Snuperim/esp32-c3-robot-arm-workshop/webots/meshes/forearm_frame.stl

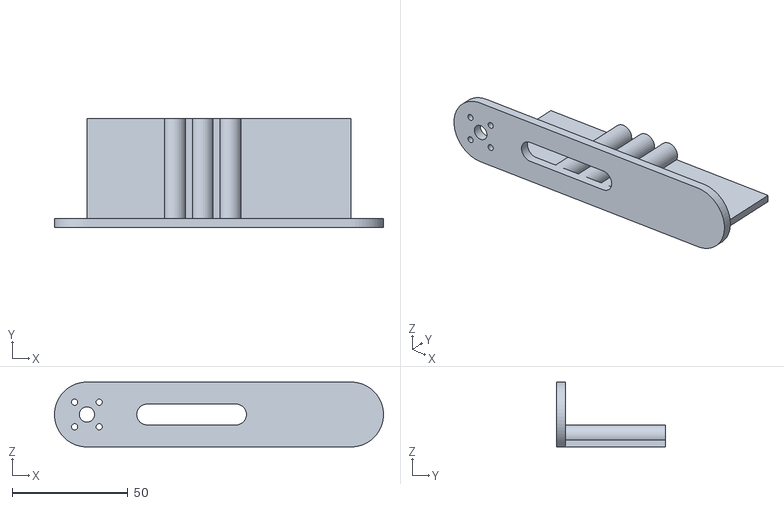
[picture p1: CAD file, 2026-10-28]
webots/meshes/forearm_frame.stl
142.0 x 47.2 x 28.0
