Snuperim/esp32-c3-robot-arm-workshop/webots/meshes/upper_arm_frame.stl

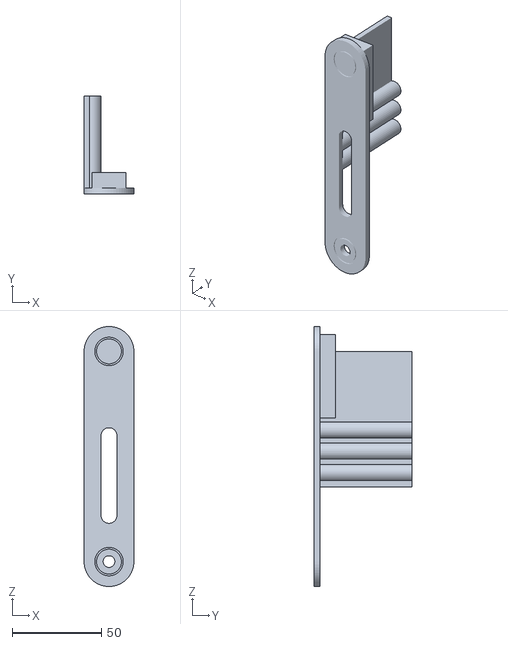
[picture p2: CAD file, 2026-10-28]
webots/meshes/upper_arm_frame.stl
28.0 x 55.2 x 146.0
