Snuperim/esp32-c3-robot-arm-workshop/webots/meshes/finger.stl

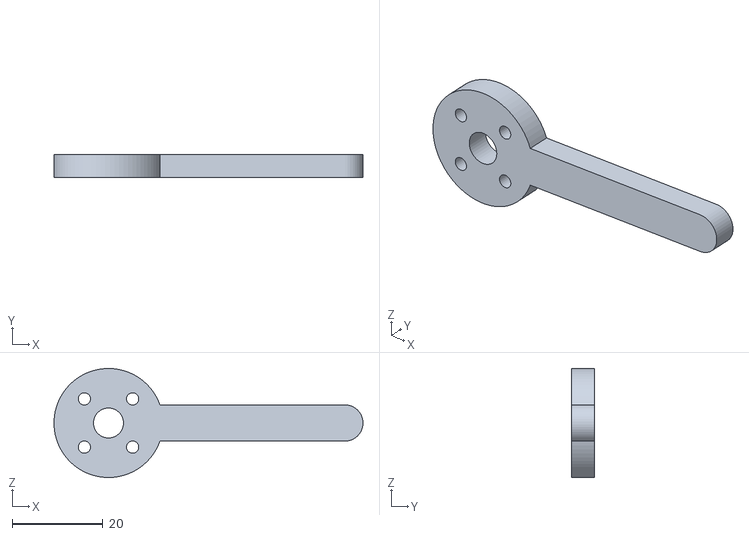
[picture p3: CAD file, 2026-10-28]
webots/meshes/finger.stl
68.0 x 5.00 x 24.0
