Snuperim/esp32-c3-robot-arm-workshop/webots/meshes/upper_arm_plate_a.stl

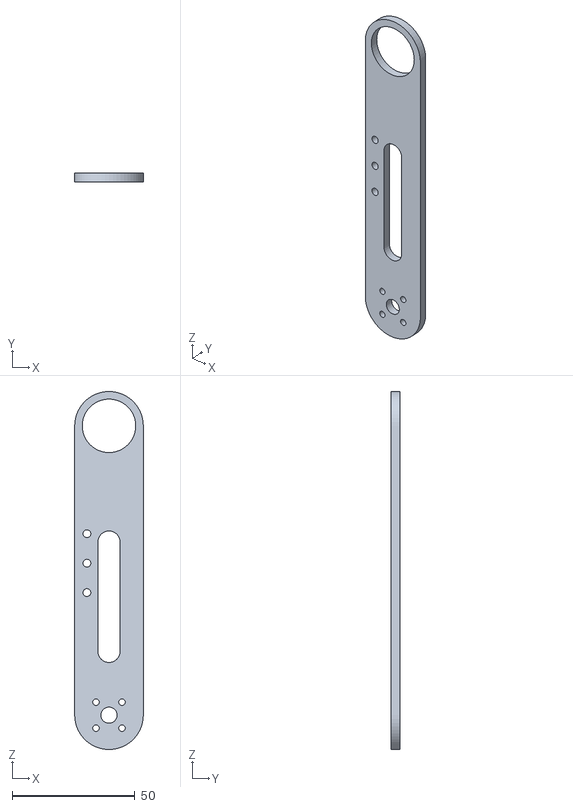
[picture p4: CAD file, 2026-10-28]
webots/meshes/upper_arm_plate_a.stl
28.0 x 3.50 x 146.0
