Snuperim/esp32-c3-robot-arm-workshop/webots/meshes/forearm_outer.stl

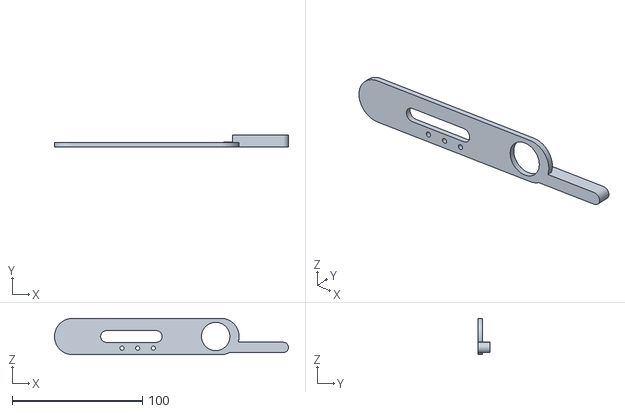
[picture p5: CAD file, 2026-10-28]
webots/meshes/forearm_outer.stl
180.0 x 9.00 x 28.0
