Snuperim/esp32-c3-robot-arm-workshop/webots/meshes/upper_arm.stl

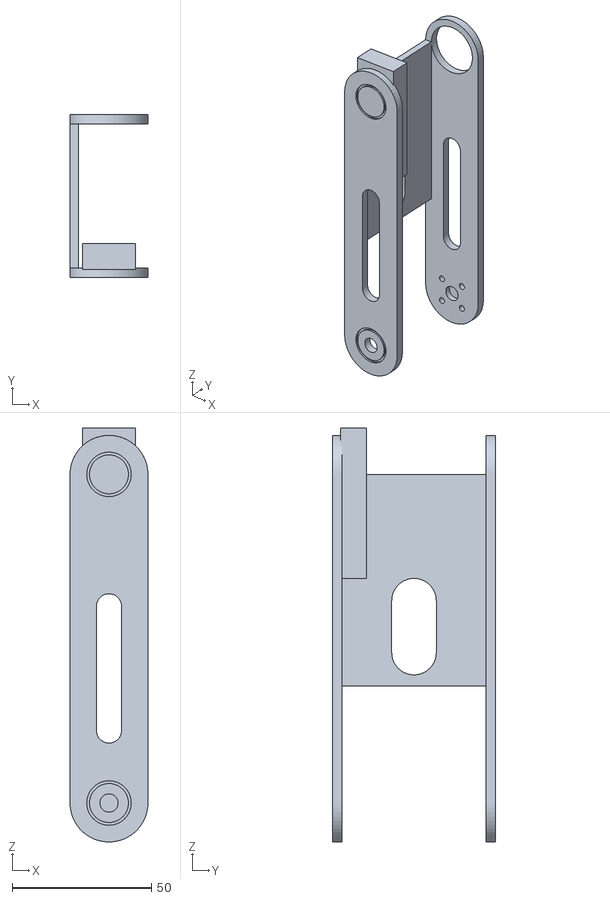
[picture p6: CAD file, 2026-10-27]
webots/meshes/upper_arm.stl
28.0 x 58.7 x 148.6
