Snuperim/esp32-c3-robot-arm-workshop/webots/meshes/forearm.stl

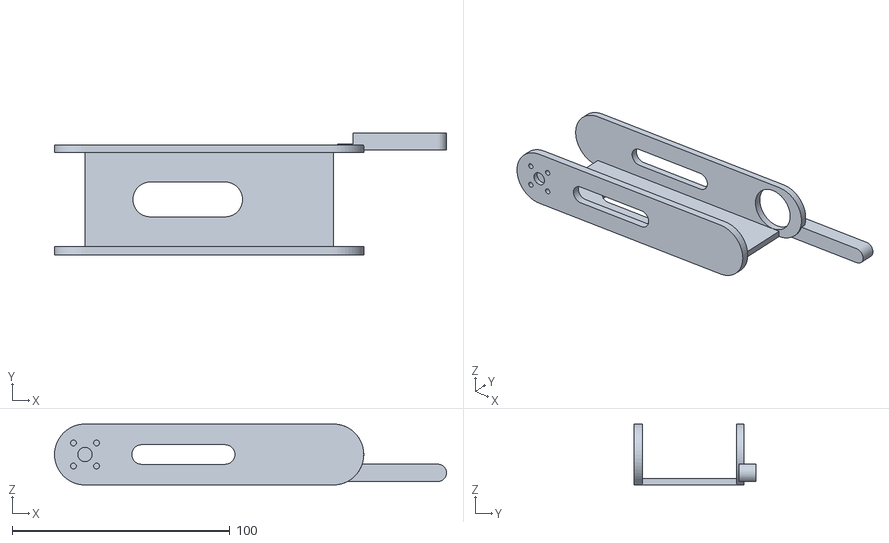
[picture p7: CAD file, 2026-10-27]
webots/meshes/forearm.stl
180.0 x 56.2 x 28.0
