Snuperim/esp32-c3-robot-arm-workshop/webots/meshes/servo_elbow.stl

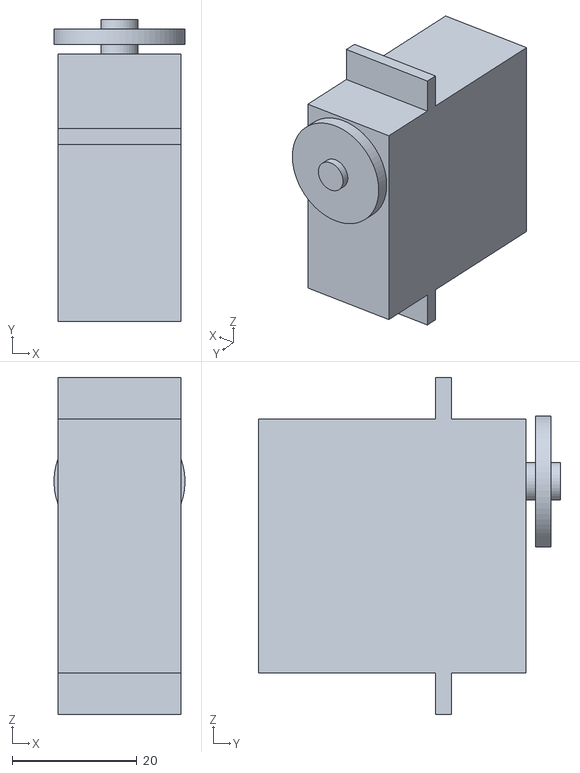
[picture p8: CAD file, 2026-10-15]
webots/meshes/servo_elbow.stl
21.0 x 48.4 x 54.0
