Snuperim/esp32-c3-robot-arm-workshop/webots/meshes/turntable.stl

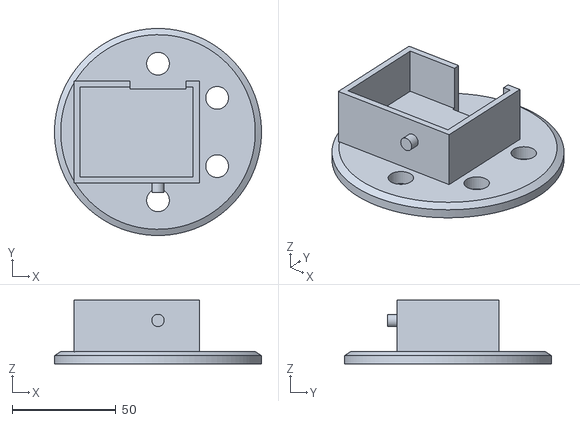
[picture p9: CAD file, 2026-10-15]
webots/meshes/turntable.stl
100.0 x 100.0 x 30.8
