Snuperim/esp32-c3-robot-arm-workshop/webots/meshes/base_plate.stl

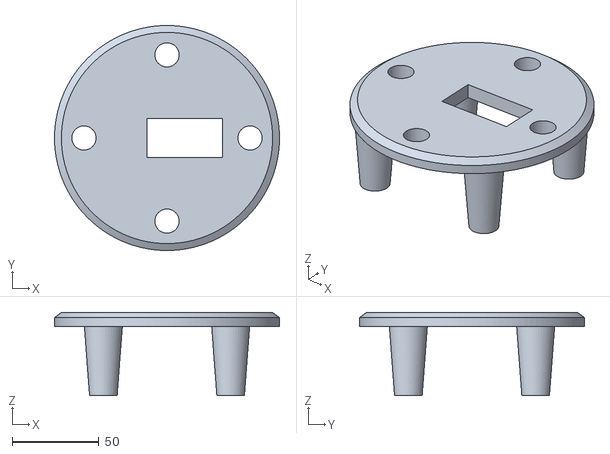
[picture p10: CAD file, 2026-10-15]
webots/meshes/base_plate.stl
130.0 x 130.0 x 48.0
