Snuperim/esp32-c3-robot-arm-workshop/(list of files, cad)

Other CAD files:
webots/meshes/servo_shoulder.stl
webots/meshes/servo_gripper.stl
webots/meshes/servo_base.stl
