Snuperim/esp32-c3-robot-arm-workshop/(commit log)

2026-10-01 Prepare ESP32-C3 robot arm workshop project
2026-10-15 Add 3D-printed arm model, jog calibration, and reach-based poses
    - Webots: replace the box arm with meshes exported from the Fusion
    design (webots/meshes), including a fixed jaw; the gripper now
    closes in the positive direction.
    - Firmware and Webots controller: per-joint CONFIG (limits, invert,
    trim), jog/print-pose calibration commands, x to stop a movement,
    gentler power-on, and poses worked out for an object 110 mm out on
    the table.
    - tools/arm_poses.py: servo angles for a table position.
    - Docs: setup, workshop, and troubleshooting guides updated.
2026-10-27 Simplify the gripper to two straight jaws and restyle the arm
    - CAD/Webots: replace the L-shaped finger with a fixed and a moving
    straight jaw driven 1:1 by one servo, add horn screw-hole circles,
    and use one grey for printed parts. Meshes re-exported.
    - Gripper convention now matches the other joints (servo - 90 degrees);
    90 = jaws touching, limit 30-88, HOME/open 40, grip 58.
    - Poses regenerated for the new jaw tip (pick: shoulder 132, elbow 124);
    tools/arm_poses.py updated to match.
    - Webots world: new gripper limits and collision shapes, and a side-on
    viewpoint (the previous one opened with the arm out of frame).
    - Docs updated.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
2026-10-28 Split the upper arm and forearm into support-free printable pieces
    - Each link is now two parts joined by three M3 screws: upper arm plate A
    and frame, forearm frame and outer plate with the fixed jaw. Every piece
    prints flat with no supports (back-web windows removed, shaft pockets are
    through-holes, jaw bar starts flush with the plate).
    - Webots: replace upper_arm.stl and forearm.stl with the four new meshes,
    update finger.stl, and load them in robot_arm.wbt.
    - Docs: add a print-orientation table and the six M3x12 screws to the
    workshop guide, and update the mesh count in the setup and
    troubleshooting guides.
2026-10-28 Fix the Webots inertia warning on the moving gripper finger
    Webots reported that the finger solid was "light and oblong according to
    its inertia matrix". Its collision shape was a 56 x 5 x 8 mm bar and a 5 mm
    disc at 0.08 kg. Use a 56 x 12 x 14 mm box and a 12 mm-thick cylinder at
    0.1 kg so the inertia is well-conditioned. The visible mesh is unchanged.
2026-10-29 Restructure the workshop guide into a follow-along
    Each chapter now has Explain (the theory), Do (steps with a "you should
    see" check) and Try your own change. Covers joints and poses, servo pulse
    width, wiring and common ground, calibration, interpolation and forward
    kinematics, and an optional Webots digital-twin step. Facilitator material
    (printed parts, orientation table, preparation) moved to the end, and the
    session plan is re-timed to 180 minutes.
2026-10-29 Add a pre-workshop setup checklist for students
    docs/PRE_WORKSHOP.md walks students through installing VS Code, Git,
    PlatformIO and the Wokwi extension (with the free licence), cloning the
    project, building the firmware, and running the virtual arm, with a check
    after every step. Webots and the real board are optional. Linked from the
    README and the workshop guide.
2026-10-29 Add an AI workflow guide, Git steps and AI moments to the workshop
    - docs/AI_WORKFLOW.md: ground rules, a debugging prompt template, Git and
    GitHub with an assistant, starting a project, common failure modes, and an
    accept-output checklist.
    - Workshop guide: six AI moment exercises, a Git push in Chapter 9, two new
    learning goals, and a re-timed plan that still totals 180 minutes.
    - Pre-workshop checklist: GitHub account and Git identity, fork and clone,
    a push check, and choosing an AI assistant (now 11 steps).
    - README links to the AI guide.
